aymenhammami7050-dev/smart-power-monitor/firmware/smart_power_monitor/secrets.example.h

#pragma once
#define BLYNK_TEMPLATE_ID    "YOUR_TEMPLATE_ID"
#define BLYNK_TEMPLATE_NAME  "Smart Power Monitor"
#define BLYNK_AUTH_TOKEN     "YOUR_AUTH_TOKEN"
#define WIFI_SSID            "YOUR_WIFI_NAME"
#define WIFI_PASS            "YOUR_WIFI_PASSWORD"
